LSV-Hohenasperg/TrimControl/Doku/20190815_182723.jpg

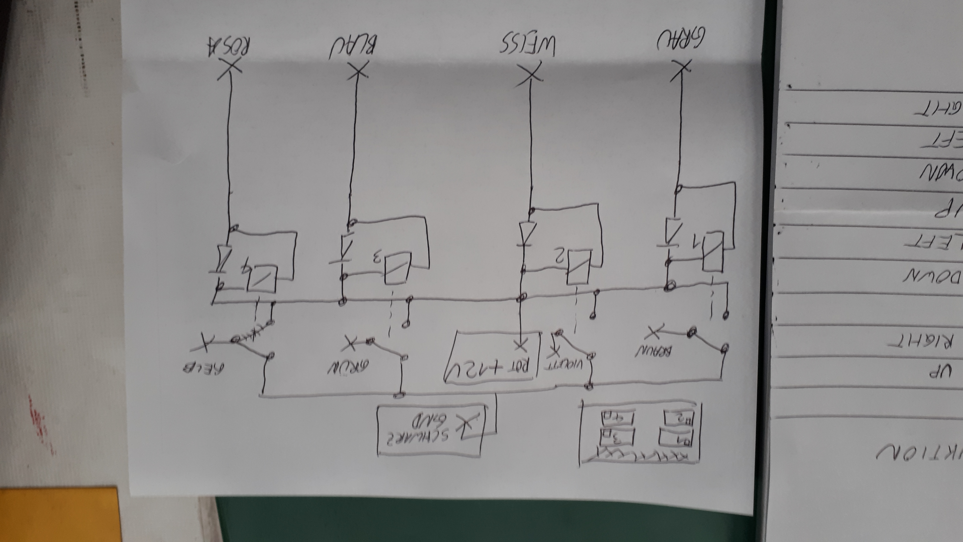
Doku/20190815_182723.jpg
