LSV-Hohenasperg/TrimControl/Doku/20190815_182706.jpg

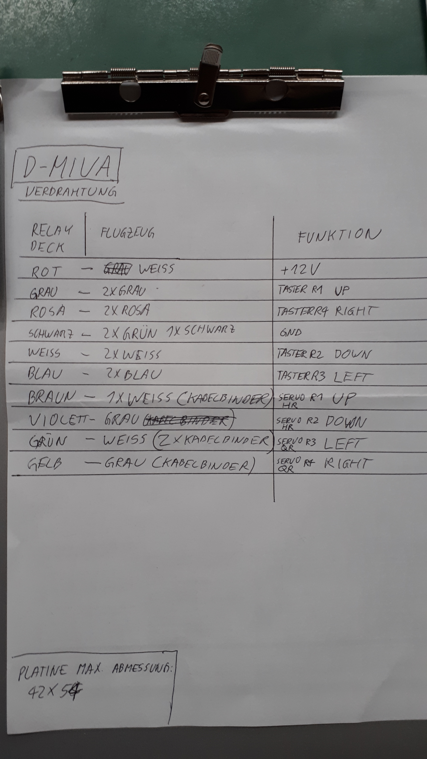
Doku/20190815_182706.jpg
