LSV-Hohenasperg/TrimControl/README.md

# TrimmControl ControllerBoard
Wir haben eine elektronische Schaltung für den Ersatz des Relais-basierten Originalcontrollers
für die Bristell entwickelt.

In diesem Repository befinden sich die Planungsdaten und auch die Eagle-Projektdateien.
Mit dem Eagle-Layout haben wir bei LeitOn.de die Platinen herstellen lassen.

# Autoren
    * Wolfgang Messerschmidt
    * Markus Kuhnla
