LSV-Hohenasperg/TrimControl/Doku/TrimControl_Brd.pdf

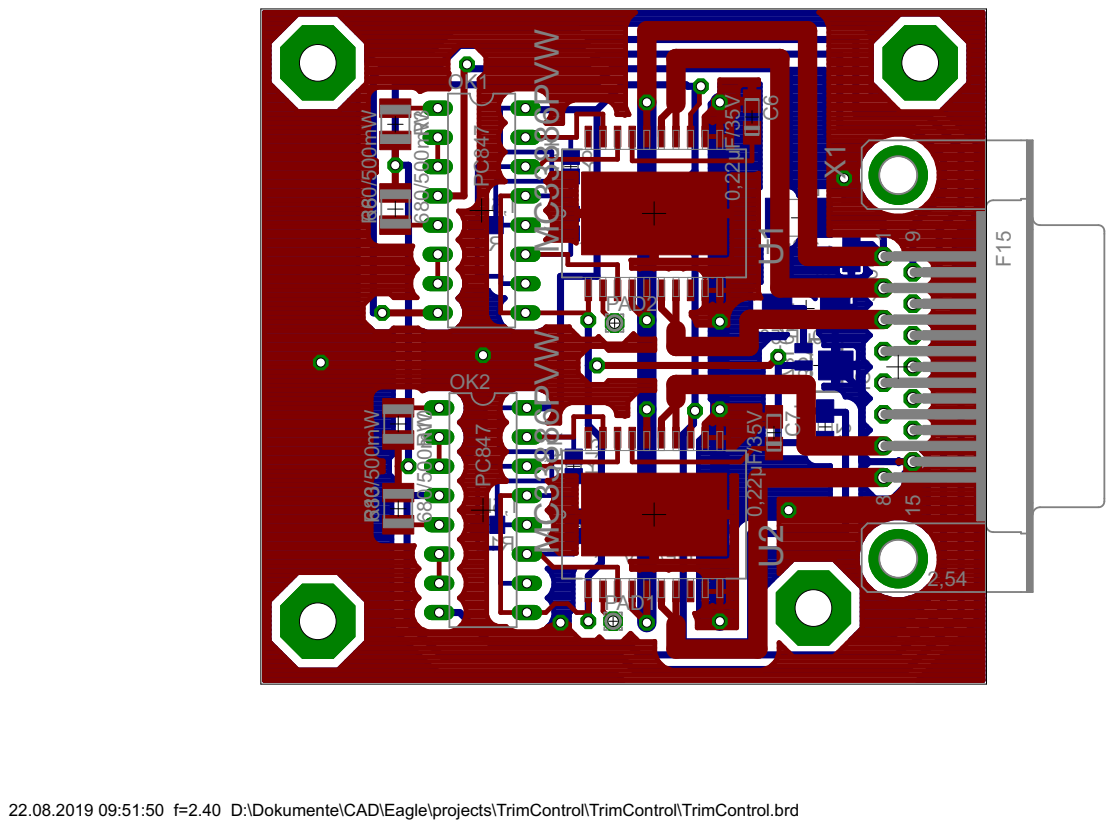
[picture p3: page 1]

22.08.2019 09:51:50 f=2.40 D:\Dokumente\CAD\Eagle\projects\TrimControl\TrimControl\TrimControl.brd
