LSV-Hohenasperg/TrimControl/Layout/TrimControl.pdf

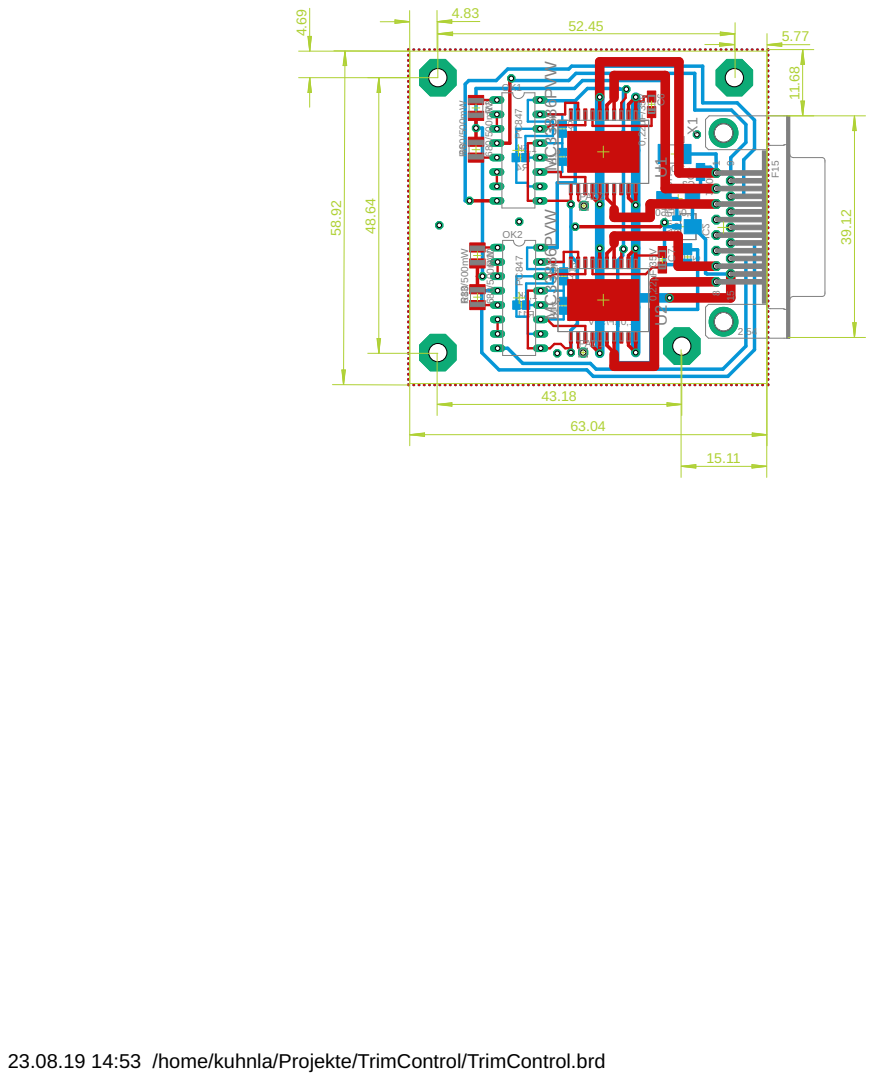
[picture p4: page 1]

23.08.19 14:53 /home/kuhnla/Projekte/TrimControl/TrimControl.brd
