LSV-Hohenasperg/TrimControl/Layout/TrimControl.brd

## EAGLE design Layout/TrimControl.brd (2019-08-29)

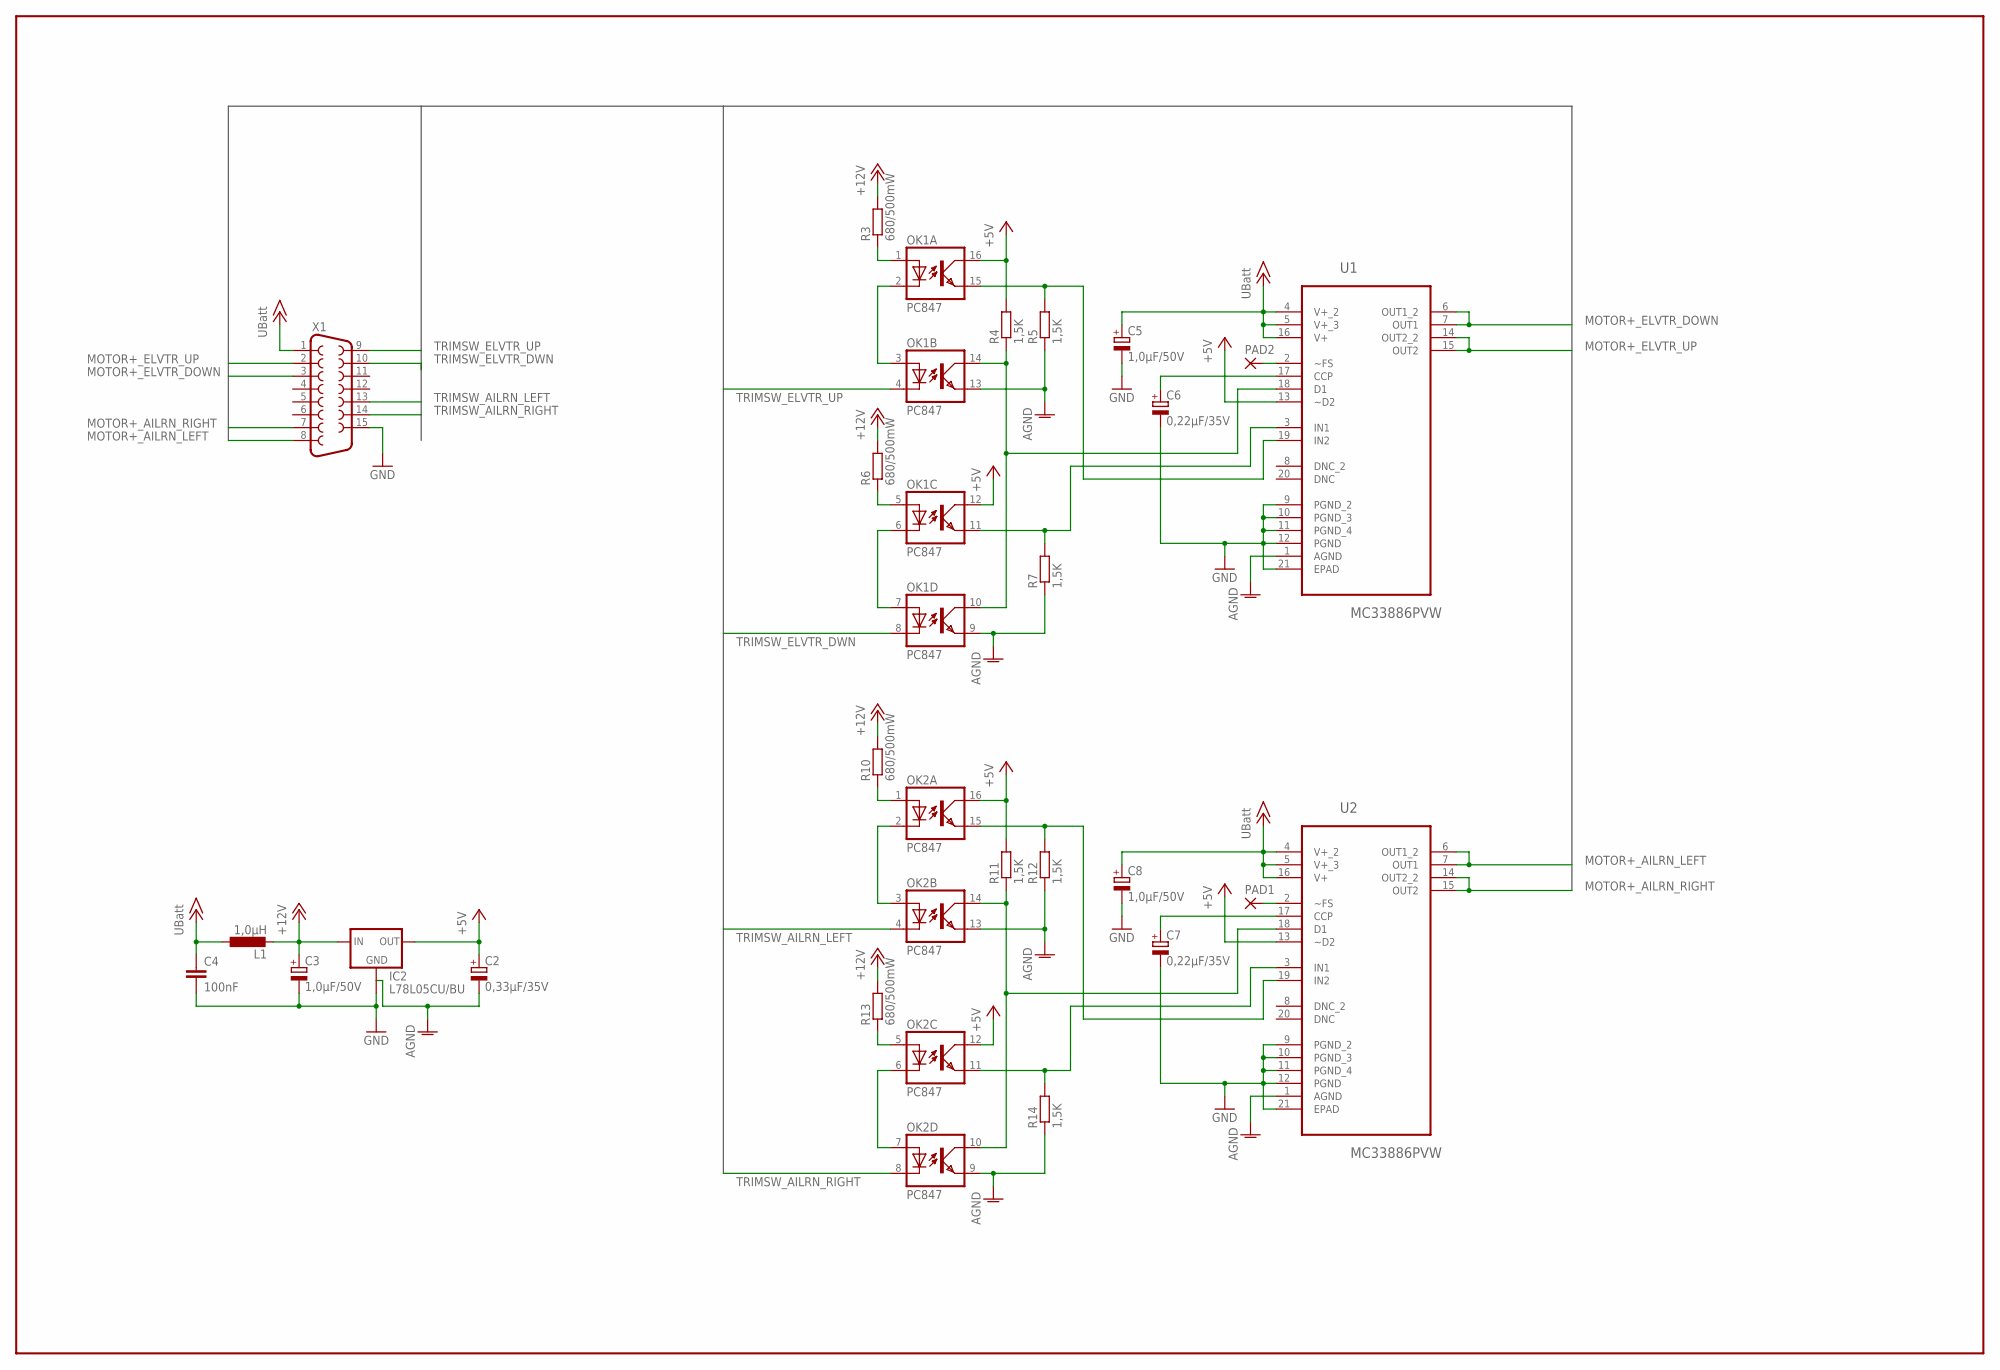
[picture p5: schematic TrimControl.sch]

Parts:
C2: 0,33µF/35V; A/3216-18R
C3, C5, C8: 1,0µF/50V; C/6032-28R
C4: 100nF; C0805
C6, C7: 0,22µF/35V; A/3216-18R
IC2: L78L05CU/BU; SOT89
L1: 1,0µH; L1812
OK1, OK2: PC847; DIL16
PAD1, PAD2: 1,6/0,9
R3, R6, R10, R13: 680/500mW; R1210
R4, R5, R7, R11, R12, R14: 1,5K; R0805
U1, U2: MC33886PVW; SOIC127P1420X340-21N
X1: F15HP

Connections:
+5V: C2.+, IC2.1 (OUT), OK1.12 (COL), OK1.16 (COL), OK2.12 (COL), OK2.16 (COL), R4.2, R11.2, U1.13 (~D2), U2.13 (~D2)
+12V: C3.+, IC2.3 (IN), L1.2, R3.2, R6.2, R10.2, R13.2
AGND: C2.-, IC2.2 (GND), OK1.9 (EMIT), OK1.13 (EMIT), OK2.9 (EMIT), OK2.13 (EMIT), R5.1, R7.1, R12.1, R14.1, U1.1 (AGND), U2.1 (AGND)
GND: C3.-, C4.2, C5.-, C6.-, C7.-, C8.-, IC2.4 (GND1), U1.9 (PGND_2), U1.10 (PGND_3), U1.11 (PGND_4), U1.12 (PGND), U1.21 (EPAD), U2.9 (PGND_2), U2.10 (PGND_3), U2.11 (PGND_4), U2.12 (PGND), U2.21 (EPAD), X1.15
MOTOR+_AILRN_LEFT: U2.6 (OUT1_2), U2.7 (OUT1), X1.8
MOTOR+_AILRN_RIGHT: U2.14 (OUT2_2), U2.15 (OUT2), X1.7
MOTOR+_ELVTR_DOWN: U1.6 (OUT1_2), U1.7 (OUT1), X1.3
MOTOR+_ELVTR_UP: U1.14 (OUT2_2), U1.15 (OUT2), X1.2
unnamed: C6.+, U1.17 (CCP)
unnamed: C7.+, U2.17 (CCP)
unnamed: OK1.1 (A), R3.1
unnamed: OK2.1 (A), R10.1
unnamed: OK1.10 (COL), OK1.14 (COL), R4.1, U1.18 (D1)
unnamed: PAD2.1, U1.2 (~FS)
unnamed: PAD1.1, U2.2 (~FS)
unnamed: OK1.2 (C), OK1.3 (A)
unnamed: OK1.5 (A), R6.1
unnamed: OK1.6 (C), OK1.7 (A)
unnamed: OK1.15 (EMIT), R5.2, U1.19 (IN2)
unnamed: OK2.2 (C), OK2.3 (A)
unnamed: OK1.11 (EMIT), R7.2, U1.3 (IN1)
unnamed: OK2.10 (COL), OK2.14 (COL), R11.1, U2.18 (D1)
unnamed: OK2.5 (A), R13.1
unnamed: OK2.6 (C), OK2.7 (A)
unnamed: OK2.11 (EMIT), R14.2, U2.3 (IN1)
unnamed: OK2.15 (EMIT), R12.2, U2.19 (IN2)
TRIMSW_AILRN_LEFT: OK2.4 (C), X1.13
TRIMSW_AILRN_RIGHT: OK2.8 (C), X1.14
TRIMSW_ELVTR_DWN: OK1.8 (C), X1.10
TRIMSW_ELVTR_UP: OK1.4 (C), X1.9
UBATT: C4.1, C5.+, C8.+, L1.1, U1.4 (V+_2), U1.5 (V+_3), U1.16 (V+), U2.4 (V+_2), U2.5 (V+_3), U2.16 (V+), X1.1

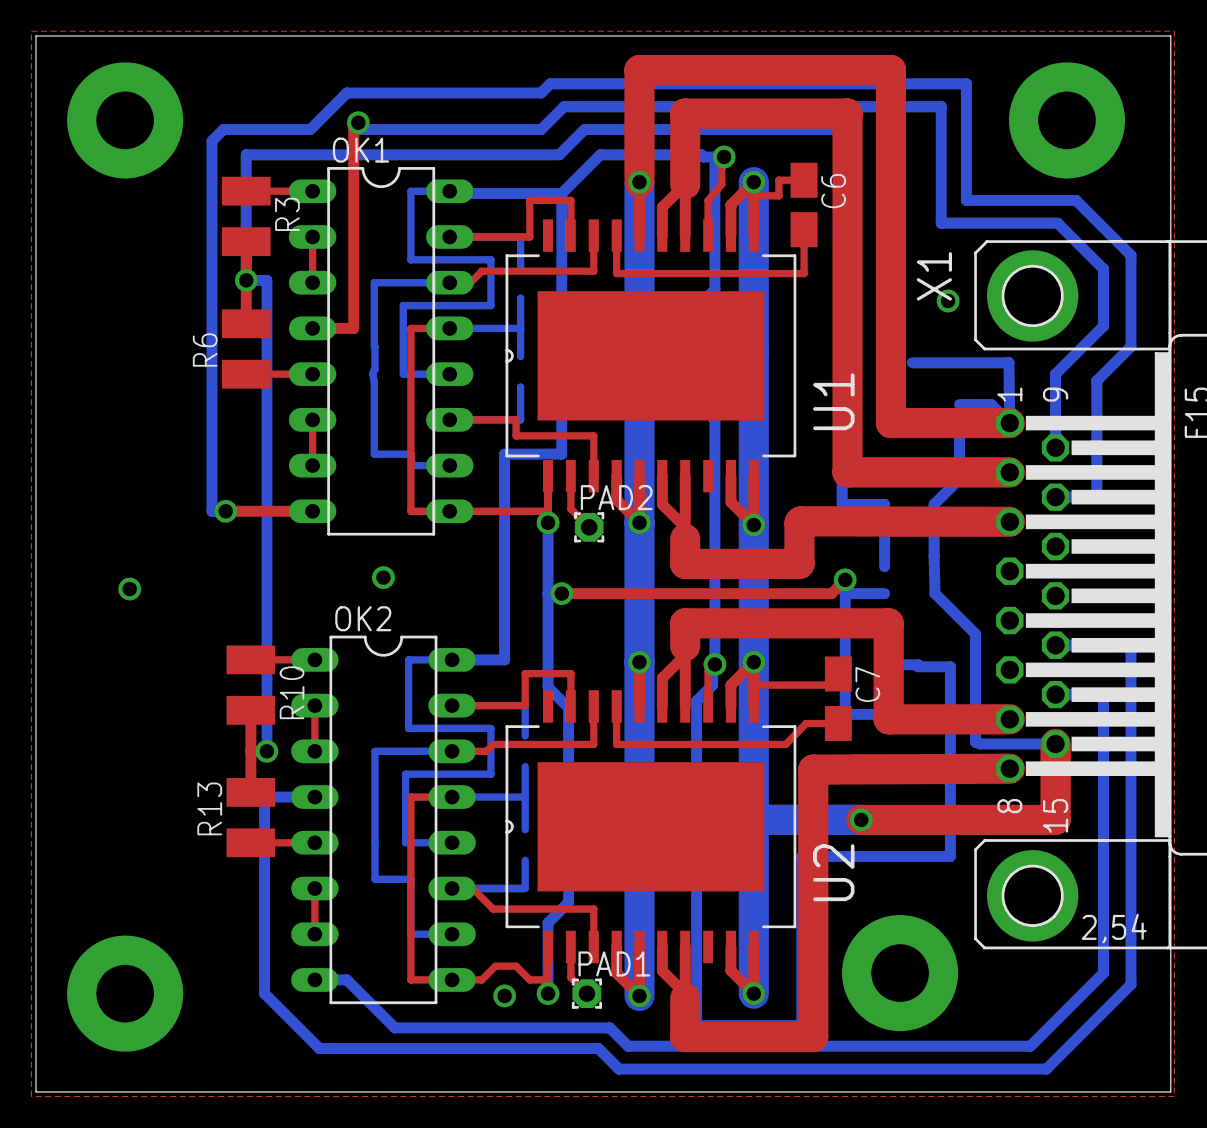
[picture p6: board TrimControl.brd from above]

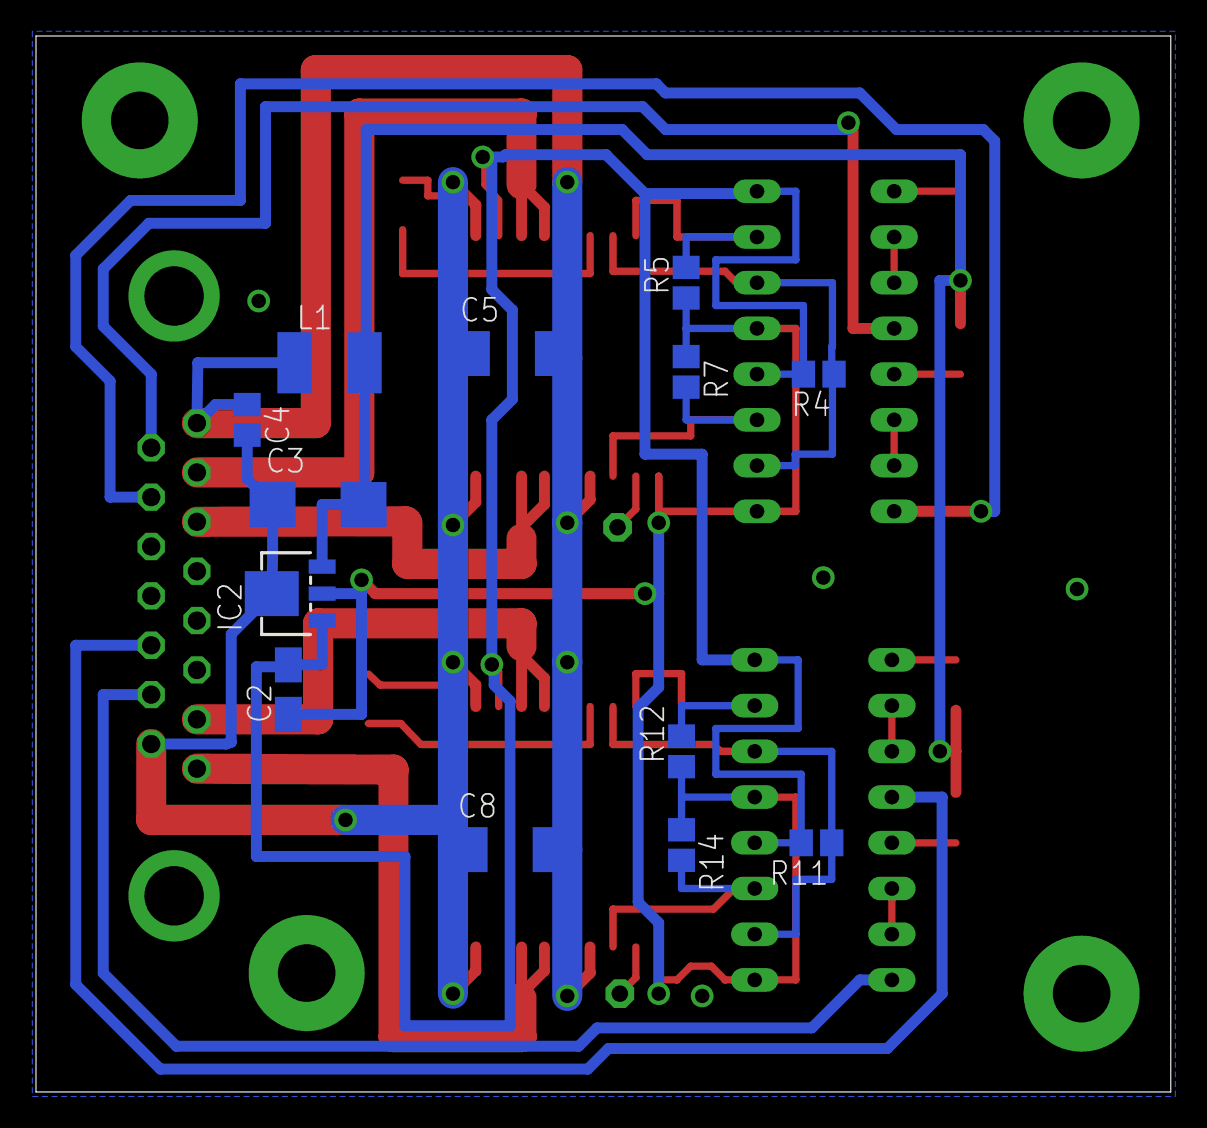
[picture p7: board TrimControl.brd from below]

Board: 2 copper layers, 63.0 x 58.7 mm, 26 parts (13 on the bottom side), 31 nets.
