LSV-Hohenasperg/TrimControl/(threads)

Thread 1 (2019-09-04):

Aufdruck auf der Platine ist suboptimal

kuhnla, 2019-09-04:
Beim Bestücken der Platine fiel auf, dass der Aufdruck für die Kondensatoren nicht die Polung angibt. Wir mussten während der Bestückung Eagle offen haben und dort nachsehen.

Thread 2 (2019-09-04):

Wunschfeature

kuhnla, 2019-09-04:
Während der ersten Tests ist es uns aufgefallen, dass wir relativ easy eine "Anfahrkurve" implementieren könnten. Die H-Brücken unterstützen ja PWM.
So könnte man die Trimservos so ansteuern, dass sie langsam anfangen und je länger man auf den Knopf drückt, desto schneller wird der Servo.
